Novin3dp/PJ3D608V3-MIPI-Bridge/Toshiba TC358870XBG mipi bridge.png

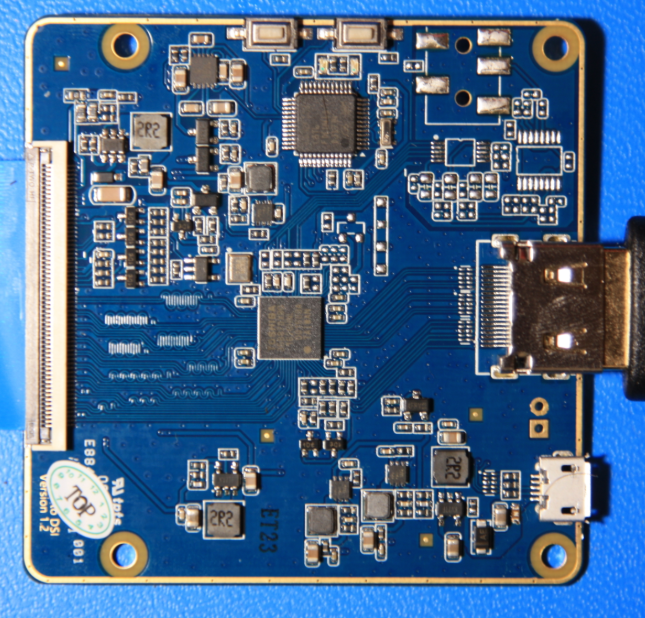
Toshiba TC358870XBG mipi bridge.png
