Novin3dp/PJ3D608V3-MIPI-Bridge/گزارش طراحی پنل DXQ608-X04 با درایور HX8252-A02 برای پرینتر رزینی.docx

# گزارش طراحی: پنل DXQ608-X04 با درایور HX8252-A برای پرینتر رزینی

Oct 8, 2026 · @Novin3dp

## ۱. خلاصه و یافته‌های کلیدی

این پنل یک LCD تک‌رنگ (بدون فیلتر رنگ) ۶٫۰۸ اینچ با ۱۶۲۰×۲۵۶۰ نقطه و گام ۵۱ میکرون است. درایور آن طبق بررسی خود شما HX8252-A است (نه A02) و دیتاشیت HX8252-A نسخه ۰۶ مبنای اعداد این گزارش است. روی کانکتور فقط یک پورت MIPI-DSI چهارلاین دیده می‌شود؛ پس طراحی درست یک مسیر ویدئویی واحد است: Spartan-6 ← یک SSD2828 ← پنل.

- تطبیق رزولوشن: ۱۶۲۰ ستون = ۵۴۰ پیکسل RGB × ۳. در HX8252-A مقدار RES=101b یعنی حالت 1080RGB×1920 که برای هر تراشه کانال‌های ۱–۸۱۰ و ۱۵۹۱–۲۴۰۰ یعنی دقیقاً ۱۶۲۰ کانال را فعال می‌کند (ص۲۸) و در جدول زمان‌بندی THA=540 پیکسل در هر پورت دارد (ص۷۶). سه ستون مجاور تک‌رنگ باید در یک پیکسل RGB بسته‌بندی شوند.
- تعداد خط: ۲۵۶۰ = ۳۲۰×۸. رجیستر VRES (۹ بیتی، گام ۸ خط، دامنه ۸۰ تا ۳۲۰) این مقدار را می‌دهد و ردیف‌های زمان‌بندی ۲۵۶۰ خطی در دیتاشیت A هست (ص۷۶)؛ ولی حالت 1080RGB رسماً ۱۹۲۰ خط دارد و توضیح VRES سقف را به V-display ربط می‌دهد (بخش ۱۰).
- یک یا دو تراشه: HX8252-A برای راه‌اندازی دو‌تراشه‌ای (Master/Slave با MIPI چپ/راست ۴+۴ لین) طراحی شده (ص۳۴)، ولی این پنل فقط یک پورت ۴ لین روی FPC دارد. تعداد IC روی شیشه را بشمارید؛ اگر یکی است مسیر این گزارش درست است.
- دو SSD2828: با یک پورت MIPI روی FPC فقط یکی لازم است. دومی فقط وقتی معنا دارد که پنل دو‌تراشه‌ای باشد.
- تغذیه: کانکتور فقط 1.8V، AVDD=+5.75V، AVEE=−5.75V و پایه‌های بک‌لایت دارد؛ پس PWRMD=11b (VSP/VSN خارجی، VGH/VGL داخلی). VCI پایه‌ی جدا ندارد و باید با اهم‌متر معلوم شود به AVDD وصل است.
- پیکسل‌کلاک: با ۲۵۶۰ خط و ۶۰ هرتز ۱۰۸٫۹ مگاهرتز (THT=700، TVT=2592) یعنی ۲٫۶ گیگابیت بر ثانیه؛ روی ۴ لین حدود ۶۵۳ مگابیت بر ثانیه برای هر لین (زیر سقف ۱ Gbps). SSD2828 این را می‌پذیرد، به شرط انتخاب درست مرجع PLL (بخش ۸ـب).
- اولین گام راه‌اندازی: حالت BIST داخلی HX8252 (رجیستر 0xB2 بیت ۰) بدون هیچ ویدئویی تغذیه، reset، GOA و نگاشت کانال‌ها را تست می‌کند.

## ۲. صفحات مطالعه‌شده و دلیل انتخاب

دیتاشیت DXQ608-X04 هفده صفحه است و فقط صفحات ۵ تا ۱۱ محتوای فنی دارند (بقیه فهرست، بازرسی ظاهری و بسته‌بندی‌اند). از دیتاشیت HX8252-A نسخه ۰۶ و دیتاشیت SSD2828QN4 نسخه ۱٫۳ این بخش‌ها را بررسی کردم؛ شماره‌ی صفحه‌ی HX8252-A همان «-P.» ابتدای هر صفحه و شماره‌ی SSD2828 شماره‌ی چاپی است.

دیتاشیت | صفحات | موضوع | چرا لازم است
DXQ608 | ۵–۷ | مشخصات مکانیکی، نقشه و جدول پین کانکتور | ابعاد، ناحیه فعال، اتصال‌ها
DXQ608 | ۸–۹ | حدود مطلق، ولتاژ تغذیه، اپتیک | ولتاژها و دما
DXQ608 | ۱۱ | زمان‌بندی MIPI و reset | حداقل‌های reset
HX8252-A | ۸–۱۴ | معرفی، پین‌ها (PWRMD، LNSW، LANSEL، CASCADE_ENB، BIST_EN) | پیکربندی سخت‌افزاری
HX8252-A | ۱۶–۲۷ | معماری تغذیه و توالی روشن/خاموش | توالی و حالت PWRMD=11
HX8252-A | ۲۸–۲۹ | رزولوشن، کانال‌های فعال، cascade | تطبیق ۱۶۲۰ ستون
HX8252-A | ۳۴–۴۵ | پروتکل DSI و نوع بسته‌ها | بسته‌های 0x23/0x29، 3Eh
HX8252-A | ۵۰–۵۳، ۶۵ | دستورات DCS | 0x10، 0x11، 0x29
HX8252-A | ۷۵–۷۷ | زمان‌بندی ورودی ویدئو | محاسبه pclk
HX8252-A | ۷۸–۸۱، ۹۶، ۱۰۵–۱۰۸ | نحوه‌ی نوشتن رجیستر، جدول و شرح صفحه ۰ | بایت‌های راه‌اندازی
HX8252-A | ۱۲۳ | BIST | تست اولیه
HX8252-A | ۱۴۱ | تشخیص نبود سیگنال و GAS | رفتار هنگام قطع
HX8252-A | ۱۴۶–۱۵۳ | مشخصات DC/AC، reset | سطوح و زمان‌ها
SSD2828 | ۱۲–۲۳ | بلوک‌دیاگرام و پین‌ها | رابط RGB و SPI
SSD2828 | ۲۵–۷۷ | رجیسترها (VICR، CFGR، PLL، LCFR) | تنظیم پل
SSD2828 | ۱۲۲–۱۲۳، ۱۳۷ | حالت‌های ویدئو و PLL | انتخاب مرجع PLL
SSD2828 | ۱۵۳–۱۶۰ | زمان‌بندی AC، reset، توالی روشن شدن | سقف pclk

بخش‌های pad و bump دیتاشیت HX8252-A (از ص۱۵۴ به بعد)، گاما و CABC برای این طراحی کاربردی ندارند. دیتاشیت HX8252-A02 که ابتدا ارسال شده بود فقط برای مقایسه خوانده شد و مبنای اعداد این گزارش نیست. محدودیت: متن PDF نمودارهای زمانی توالی تغذیه را درهم ریخته استخراج کرده، پس اعداد آن‌ها فقط از متن‌های قابل اعتماد گرفته شده و جاهای نامطمئن علامت خورده‌اند.

## ۳. مشخصات پنل و کانکتور ۵۰ پین

پنل ۱۶۲۰×۲۵۶۰ با ناحیه فعال 82.62×130.56 میلی‌متر، گام دقیقاً ۵۱ میکرون در هر دو جهت دارد (82.62/1620 و 130.56/2560)؛ قطر قطری ≈154٫5 میلی‌متر = ۶٫۰۸ اینچ.

پارامتر | مقدار | منبع
ابعاد خارجی | 87.02 × 138.56 × 1.3 mm | DXQ608 ص۵
درایور | HX8252-A (نام روی ص۵؛ نقشه‌ی ص۶ نام A02 هم دارد) | ص۵ و ۶
حالت نمایش | Normally Black، IPS | ص۵
ولتاژ منطقی | 1.8V (تیپ)، حد 1.7 تا 3.6V | ص۵ و ۸
تغذیه آنالوگ روی کانکتور | AVDD=+5.75V، AVEE=−5.75V | ص۷
دمای کار / نگهداری | −20..+70°C / −30..+70°C | ص۸
کنتراست / پاسخ | 1000 / 35ms (TR+TF) | ص۹
عبور نور با پلاریزر | 7٪ | ص۹
جریان مصرفی، ولتاژ LED، روشنایی | خالی در دیتاشیت | ص۸
Reset | حداقل پهنای پالس 10µs در دیتاشیت پنل و 20µs در HX8252؛ زمان کامل شدن 5ms (120ms اگر Sleep In) | ص۱۱

جدول پین‌ها (ص۷). نکته: پین‌های دیفرانسیلی در جدول به‌صورت متناوب آمده‌اند؛ جفت‌ها همان نام‌های یکسان‌اند (مثلاً D3 = پین ۸ و ۱۰).

پین | نام | شرح و نکته طراحی
1، 2، 6، 7، 12، 13، 18، 19، 24، 25، 30، 31، 36، 37، 42، 43 | GND | زمین؛ همه وصل شوند
3 | AVEE | −5.75V؛ ورودی VSN درایور
4 | AVDD | +5.75V؛ ورودی VSP درایور
5 | HS | «همگام‌ساز افقی»؛ در حالت MIPI بلااستفاده به‌نظر می‌رسد، خالی بگذارید تا تأیید شود
8، 10 | D3N، D3P | لین داده ۳
9، 11 | D0N، D0P | لین داده ۰
15، 17 | D1N، D1P | لین داده ۱
20، 22 | D2N، D2P | لین داده ۲
14، 16 | CLKN، CLKP | کلاک
21، 23، 26–29، 32–35، 50 | NC | باز
38 | RESET | ریست سخت‌افزاری، فعال‌پایین
39، 41 | VDD (1.8V) | تغذیه منطق (VDDI)
40 | TE | خروجی Tearing Effect (فقط با پیکربندی GPO)
44 | LEDPWM | PWM بک‌لایت سفید (برای پرینتر معمولاً بلااستفاده)
45، 46 | ID1/ID2 | شناسه ماژول؛ در FPC به VDDI وصل است
47، 49 | LEDK1 | کاتد بک‌لایت
48 | LEDA | آند بک‌لایت

## ۴. تطبیق ۱۶۲۰×۲۵۶۰ با HX8252

HX8252-A دو تراشه‌ی ۲۴۰۲ کاناله را cascade می‌کند؛ هر تراشه ۲۴۰۰ خروجی سورس دارد. در جدول‌های ۶٫۱ و ۶٫۲ (ص۲۸) حالت RES=101b (1080RGB×1920) برای هر تراشه کانال‌های ۱–۸۱۰ و ۱۵۹۱–۲۴۰۰ را فعال و ۸۱۱–۱۵۹۰ را غیرفعال می‌کند: ۸۱۰+۸۱۰ = ۱۶۲۰ کانال، دقیقاً برابر ستون‌های پنل. در جدول زمان‌بندی (ص۷۶) همین حالت THA=540 دارد، یعنی ۵۴۰ پیکسل RGB در هر پورت. نتیجه: پنل برای درایور یک تراشه با ۵۴۰ پیکسل RGB است که هر زیرپیکسل آن یک نقطه‌ی تک‌رنگ شده. فرض من این است که فقط یک تراشه روی شیشه است و پایه‌ی CASCADE_ENB بالا (حالت Single) است؛ اگر پنل دو تراشه داشته باشد، این بخش و بخش ۶ باید دوباره بررسی شوند.

پیامدهای طراحی:

- رجیستر 0xB3 (صفحه ۰): RES[2:0]=101b یعنی B3=05h. ZTYPE_SEL و PWRMD_XOR صفر بمانند. توجه: پیش‌فرض B3 در جدول رجیستر 03h (RES=011، 1280RGB×2048) است، ولی جدول ۶٫۱ پیش‌فرض را 000 می‌گوید؛ پس مقدار را صریحاً بنویسید (ص۲۸ و ۹۶).
- پنل از نوع Stripe فرض می‌شود (ZIGZAG_SEL=0، پیش‌فرض 0xB2=02h)، پس SR1 و SL1 غیرفعال‌اند. اگر تصویر ناهمگون شد این فرض را عوض کنید.
- NBW_SEL=1 (Normal Black) پیش‌فرض است و با متن دیتاشیت پنل (ص۵) می‌خواند.
- خطوط: ۲۵۶۰ = ۳۲۰×۸. VRES[8:0]=0x140: بایت 0xB4=0x40 و بیت VRES[8] یعنی بیت ۷ رجیستر 0xB6 باید ۱ شود. VRES_FIX=0 (پیش‌فرض) یعنی خطوط از VRES می‌آیند نه از RES. دامنه‌ی VRES در دیتاشیت A برابر ۸۰ تا ۳۲۰ و گام ۸ خط است (ص۱۰۶)، و مقدار پیش‌فرض 0x0F0 (۱۹۲۰ خط).
- ترتیب بسته‌بندی: هر پیکسل MIPI = [R,G,B] = ستون‌های 3k، 3k+1، 3k+2 تصویر تک‌رنگ. اگر چپ و راست برعکس بود LR_XOR (0xB2 بیت ۴) یا جابه‌جایی R/B (RB_SWAP، 0xB6 بیت ۴) را به‌جای تغییر FPGA امتحان کنید.

## ۵. تغذیه و توالی روشن/خاموش شدن

روی کانکتور هیچ پین VCI، VGH، VGL یا VCOM نیست، پس این‌ها داخل ماژول ساخته می‌شوند. چون AVDD/AVEE مستقیم از بیرون می‌آیند، حالت درست PWRMD[1:0]=11b است (پین پیش‌فرض بالا؛ ص۱۱، شکل ۵٫۵ ص۲۱): VSP/VSN خارجی، VGH/VGL با شارژ پمپ داخلی. VGH/VGL پیش‌فرض +15V/−10V هستند (0xBE=23h، 0xBF=14h) و با ±5.75V قابل‌دستیابی‌اند (محدوده‌ی خروجی VGH ‏8 تا 19V و VGL ‏−16 تا −6V؛ ص۱۴۷).

ریل | محدوده مجاز دیتاشیت | مقدار طراحی | نکته
VDDI | 1.7 تا 3.6V (حد مطلق 3.96V) | 1.8V | همان منطق FPC (پین ۳۹، ۴۱)
AVDD (VSP) | 4.0 تا 6.5V (حد مطلق 6.9V) | +5.75V | زیر 3.5V مکانیزم GAS فعال می‌شود
AVEE (VSN) | −4.0 تا −6.5V (حد مطلق −6.9V) | −5.75V | زیر −3.5V GAS
VCI | 2.7 تا 6.5V | احتمالاً داخل ماژول به AVDD وصل است | باید با اهم‌متر تأیید شود

نیازهای عملی:

- ریپل AVDD/AVEE را کم نگه دارید؛ این ریل‌ها مستقیماً منبع رانش سورس‌اند و خطای خروجی سورس خود IC بین ۲۰ تا ۵۰ میلی‌ولت (بسته به سطح خاکستری) است (ص۱۴۷).
- جریان AVDD/AVEE در هیچ‌یک از دیتاشیت‌ها نیامده (جریان مصرفی ص۸ خالی است)، فقط جریان تست ۶۴۰×۱۹۲۰ در HX8252 آمده: Ivdd≤18.3mA، Ivci≤2.5mA. برای تغذیه ±5.75V حداقل ۲۰۰ میلی‌آمپر هر ریل (با اندازه‌گیری نهایی) فرض کنید.
- پین VDD_OTP روی FPC نیست؛ هرگز برنامه‌ریزی OTP نکنید.

توالی پیشنهادی (از شکل‌های ص۲۶–۲۷؛ فاصله‌های دقیق شکل‌ها در متن استخراج‌شده ناخوانا بود و باید با خود PDF مقایسه شود):

1. VDDI (1.8V) را وصل کنید، RESET پایین نگه داشته شود، لین‌های MIPI در LP-11.
2. AVDD/AVEE را بالا بیاورید، چند میلی‌ثانیه صبر کنید.
3. RESET را رها کنید؛ حداقل پهنای پایین ۲۰ میکروثانیه (HX8252) — عملاً ۱ میلی‌ثانیه پایین؛ بعد از آن HX8252-A بیش از ۱ ms برای بارگذاری OTP می‌خواهد (شکل ۵٫۶ ص۲۶) و دیتاشیت پنل ۵ ms (ص۱۱ پنل: 5ms؛ 120ms اگر از Sleep In آمده).
4. کدهای راه‌اندازی رجیستر را بفرستید (جدول بخش ۸)، سپس HS کلاک و ویدئوی پایدار.
5. DCS 0x11 (Sleep Out)، حداقل ۱۲۰ میلی‌ثانیه صبر، سپس DCS 0x29 (Display On).
6. خاموش‌کردن: DCS 0x28، DCS 0x10، حداقل ۱۰۰ میلی‌ثانیه (ص۲۷)، سپس قطع ویدئو و سپس تغذیه‌ها. در قطع ناگهانی، مدار GAS تصویر را تخلیه می‌کند.

## ۶. MIPI: زمان‌بندی ویدئو، پیکسل‌کلاک و نرخ لین

زمان‌بندی ویدئو بر اساس جدول صفحه ۷۶ دیتاشیت HX8252-A (حالت 1080RGB×1920 با VRES=2560 خط؛ مقادیر typical):

پارامتر | افقی (pclk) | پارامتر | عمودی (خط)
THT (کل) | 700 | TVT (کل) | 2592
THS (HSYNC) | 20 | TVS (VSYNC) | 2
THB (back porch) | 70 | TVB | 12
THA (فعال) | 540 | TVA | 2560
THF (front porch) | 70 | TVF | 18

جمع افقی 20+70+540+70 = 700 و جمع عمودی 2+12+2560+18 = 2592 است. در MIPI هر پورت نصف پیکسل‌ها را می‌برد، بنابراین THA=540 یعنی ۵۴۰ پیکسل RGB (۱۶۲۰ ستون تک‌رنگ) در هر پورت.

نرخ فریم و سرعت لاین (محاسبه: pclk = THT×TVT×fps؛ سرعت هر لاین = pclk×24/4 با ۴ لاین):

نرخ فریم | pclk | سرعت هر لاین MIPI
60 Hz | 108.86 MHz | 653 Mbps
50 Hz | 90.72 MHz | 544 Mbps
40 Hz | 72.58 MHz | 435 Mbps
30 Hz | 54.43 MHz | 327 Mbps

یادداشت‌ها:

- زمان یک خط 700/108.86 MHz ≈ 6.43 µs است؛ زمان افت سورس ۴٫۲ µs (ص۱۵۲) و باید داخل این بازه جا شود.
- سقف سرعت MIPI در این دیتاشیت 1 Gbps/lane است (ص۱۱)؛ ۶۵۳ Mbps با حاشیه کافی جا می‌شود. برای چاپگر رزینی ۳۰ Hz هم کافی است و فشار روی FPGA و SSD2828 را نصف می‌کند.
- دستور 3Eh (write memory continue) در ص۳۸ و حداکثر ۴۸ فرمان در هر burst پرسرعت در ص۳۷ آمده است.
- بین فرمان‌های HS باید حداقل ۱۰ µs در LP بماند (ص۷۸).
- رفتار هنگام قطع سیگنال ویدئو (no-signal) در ص۱۴۱ شرح داده شده؛ برای اطمینان قبل از قطع pclk پنل را به Sleep ببرید.

## ۷. نمودار معماری سیستم

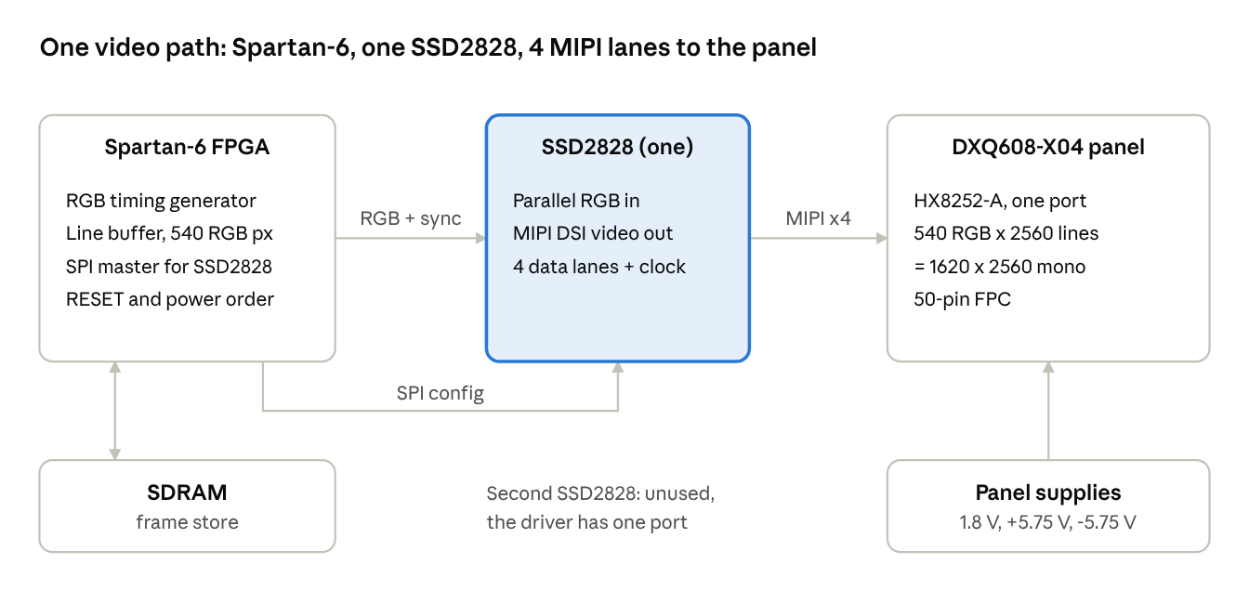
[picture p3: figure]
معماری مسیر ویدئو · FPGA → SSD2828 → پنل

معماری مسیر ویدئو · FPGA → SSD2828 → پنل

مسیر تصویر یکی است: FPGA پیکسل‌های RGB و سینک را به یک SSD2828 می‌دهد و آن همان را به MIPI DSI چهارلین تبدیل می‌کند؛ همان FPGA از طریق SPI رجیسترهای SSD2828 را پر می‌کند و در زمان راه‌اندازی دستورهای DCS را به همان طریق (انفجار LP/HS) به HX8252 می‌فرستد. SDRAM فقط با FPGA ارتباط دارد. پین RESET (۳۸) و ترتیب روشن شدن تغذیه‌ها (بخش ۵) هم با FPGA کنترل می‌شود. شکل فقط مسیر پیشنهادی من را نشان می‌دهد؛ جزئیات SSD2828 در بخش ۸ـب آمده است.

## ۸. رجیسترها و دنباله‌ی راه‌اندازی

نحوه‌ی نوشتن: رجیسترهای HX8252-A با بسته‌ی Generic Long Write (DI=0x29) نوشته می‌شوند؛ بایت اول داده آدرس شروع و بایت‌های بعدی مقدارها هستند. انتخاب صفحه‌ی رجیستر با Generic Short Write دوپارامتری (DI=0x23) و داده‌ی B0 pp انجام می‌شود. مقدار پیش‌فرض B0 برابر 0Fh است، پس صفحه‌ی ۰ را صریحاً انتخاب کنید. دستورهای DCS مثل 0x11 و 0x29 بسته‌ی کوتاه بدون پارامتر (DI=0x05) هستند. بین فرمان‌های HS حداقل ۱۰ µs در LP بمانید (ص۷۸) و در هر burst بیش از ۴۸ فرمان نفرستید (ص۳۷).

رجیسترهای صفحه‌ی ۰ که برای این پنل مهم‌اند:

آدرس | بیت‌ها | پیش‌فرض | مقدار این پروژه | کار
0xB2 | [4] LR_XOR، [3] ZIGZAG_SEL، [1] NBW_SEL، [0] BIST | 02h | 02h (عادی)، 03h (BIST) | جهت چپ/راست، نوع پنل (Stripe=0)، Normal Black=1، تست داخلی
0xB3 | [5:4] PWRMD_XOR، [3] VRES_FIX، [2:0] RES | 03h (جدول رجیستر) | 05h | RES=101b یعنی 1080RGB×1920 (۸۱۰+۸۱۰ کانال)؛ VRES_FIX=0 یعنی خطوط از VRES
0xB4 | [7:0] VRES[7:0] | F0h | 40h | بخش پایین تعداد خط÷۸
0xB5 | ZDATA | A5h | A5h | فقط برای Zigzag؛ تغییرش ندهید
0xB6 | [7] VRES[8]، [4] RB_SWAP، [1] DITHER، [0] D_GAM | 00h | 80h | VRES[8]=1 پس VRES=0x140=320 یعنی ۲۵۶۰ خط
0xB7 | [0] CASCADE_XOR | — | 00h | حالت Single (پین CASCADE_ENB بالا)
0xB8 | [7] GOA_EN، [6] VCOM_EN، [5] PNSW، [3:2] LNSW، [1:0] LANSEL | C0h | C0h | GOA و VCOM روشن، چهار لین

توجه: بیت‌های BIST، PWRMD، PNSW، LNSW و LANSEL با پین متناظر XOR می‌شوند. پین BIST_EN پیش‌فرض پایین است، پس نوشتن ۱ در بیت BIST حالت تست را روشن می‌کند. برای PWRMD هم پین پیش‌فرض بالا و XOR=00 همان 11b (VSP/VSN خارجی، VGH/VGL داخلی) را می‌دهد. پیش‌فرض B3 در جدول رجیستر 03h و در جدول ۶٫۱ برابر RES=000 است؛ پس B3 را همیشه صریحاً بنویسید.

دنباله‌ی پیشنهادی (قبل از ارسال ویدئو):

گام | بسته | بایت‌ها | انتظار بعد
۱ | Hardware reset | RESET پایین ≥20 µs | >1 ms (بارگذاری OTP)، پیشنهاد ۵ ms
۲ | Short 0x23، انتخاب صفحه | B0 00 | ≥10 µs LP
۳ | Long 0x29، WC=5 | B3 05 40 A5 80 | ≥10 µs LP
۴ | (اختیاری) Short 0x23 برای BIST | B2 03 … سپس B2 02 برای بازگشت | چند ثانیه نگاه کردن
۵ | شروع HS کلاک و ویدئوی پایدار | از SSD2828 | چند فریم
۶ | DCS 0x11 (Sleep Out) | 11 | ≥120 ms
۷ | DCS 0x29 (Display On) | 29 | —

نکات مهم:

- بسته‌ی B3 05 40 A5 80 فرض می‌کند بایت‌ها پشت‌سرهم در B3، B4، B5 و B6 می‌نشینند. با خواندن بازگشتی یا شمردن خطوط تصویر تأیید کنید.
- ماژول احتمالاً مقدارهای بهینه را از OTP می‌خواند (ص۱۱ پنل). بایت‌های B1 (VENDER_ID) را دست نزنید.
- نوشتن 0xB6=80h بقیه‌ی بیت‌های B6 (RB_SWAP، دیترینگ، گامای دیجیتال) را صفر می‌کند؛ اگر OTP غیرصفر بوده، اول مقدار فعلی را بخوانید.
- اگر پنل دو تراشه‌ی HX8252-A دارد (Master/Slave)، تنظیم CASCADE و تقسیم چپ/راست متفاوت است و این جدول باید بازبینی شود.

## ۸ـب. SSD2828: محدودیت‌ها و تنظیم

این بخش از دیتاشیت SSD2828 (QN4 Rev 1.3) برداشته شده است.

موضوع | مقدار دیتاشیت | نتیجه برای این پروژه
ورودی | RGB تا ۲۴ بیت + SPI برای رجیستر | FPGA مستقیماً pclk، HS، VS، DE و ۲۴ بیت داده می‌دهد
خروجی | یک پورت DSI، تا ۱ Gbps در هر لین | یک چیپ برای پنل با یک پورت کافی است
محدودیت pclk | tpclk ≥ 24T، با T = 1/(نرخ PLL × تعداد لین) | pclk ≤ نرخ لین × ۴ ÷ ۲۴؛ برای 108.86 MHz نرخ لین حداقل 653 Mbps است
PLL | 62.5 تا 1000 MHz | پیشنهاد حدود 800 Mbps (UI=1.25 ns؛ داخل بازه‌ی 1.0–12.5 ns پنل)
مرجع PLL | fIN/fREF بین 5 تا 100 MHz | pclk=108.9 MHz از 100 MHz بالاتر است، پس CSS=1 (مرجع از pclk) ممکن نیست؛ از TX_CLK (8–30 MHz، مثلاً 25 MHz) استفاده کنید
ریست | RESET ≥10 ms | قبل از SPI حداقل ۱۰ ms صبر کنید
تغذیه | MVDD 1.2 V، VDDIO 1.8 یا 3.3 V | VDDIO را با سطح FPGA یکی کنید
SPI | دوره ≥ 8T | با 25 MHz مرجع، SPI را کند (چند MHz) نگه دارید

نکات اجرایی:

- زمان‌بندی ویدئو (بخش ۶) در رجیسترهای VICR به‌صورت VSA=2، VBP=12، VFP=18، HSA=20، HBP=70، HFP=70، پیکسل فعال=540 و خط فعال=2560 تنظیم می‌شود. جای دقیق بیت‌ها را از بخش رجیسترها در دیتاشیت SSD2828 بخوانید؛ من آن‌ها را اینجا حدس نمی‌زنم.
- فرمان‌های HX8252 (B0، B3 و غیره) از راه SPI به رجیسترهای packet-size و packet-data (0xBC و 0xBF) و با CFGR در حالت LP فرستاده می‌شوند؛ بعد از آن حالت Video و HS را روشن کنید. فرمت دقیق فریم SPI (دیتاشیت ص۱۳۹ به بعد) هنوز استخراج نشده و باید پیش از نوشتن کد SPI تأیید شود.
- ترتیب: ریست SSD2828 → PLL و تایمینگ → ارسال دستورهای HX8252 در LP → روشن کردن ویدئوی HS → Sleep Out و Display On.
- سرعت لین را روی نمونه با اسکوپ یا خطای تصویر بسنجید؛ اگر ناپایدار بود نرخ فریم را به ۵۰ یا ۴۰ هرتز ببرید (بخش ۶).

## ۸ـج. مسیر اختیاری: MIPI مستقیم از FPGA بدون SSD2828

مدل FPGA شما XC6SLX9-2TQG144C است. از دیتاشیت DS162 و دانش عمومی D-PHY نتیجه می‌گیریم که این مسیر شدنی است، ولی خطر بیشتری از مسیر با SSD2828 دارد. پیشنهاد: نمونه‌ی اول با SSD2828، مسیر مستقیم را جاگذاری اختیاری روی همان برد بگذارید.

موضوع | مقدار / نتیجه | منبع
سرعت فرستنده | OSERDES2 با پهنای ۴ تا ۸ بیت در grade ‏-2 تا 950 Mb/s → برای 653–800 Mbps کافی است | DS162 جدول ۲۵
سطح HS | LVDS_25: VOD ≈ 247–454 mV، VOCM ≈ 1.125–1.375 V؛ D-PHY نوسان و common-mode حدود 200 mV می‌خواهد → شبکه‌ی مقاومتی لازم است | DS162 جدول ۱۰ + دانش عمومی D-PHY
حالت LP | سطح ~1.2 V تک‌سر روی همان جفت‌ها → پین‌های GPIO جدا و مقاومت‌های ترکیبی | دانش عمومی D-PHY
بانک | LVDS_25 نیاز به VCCO=2.5V دارد؛ خروجی LVCMOS12 در همان بانک ممکن نیست | DS162 جدول ۸
تعداد پین | ۵ جفت HS + ۱۰ پین LP ≈ ۲۰ پین؛ تعداد دقیق I/O و پین‌های مناسب BUFPLL را از UG385 بگیرید | تخمین، نیاز به تأیید
کنترلر حافظه (MCB) | در بسته‌ی TQG144 وجود ندارد → کنترلر SDRAM باید در منطق FPGA نوشته شود. برای SDR ساده است؛ برای DDR نه | DS162 جدول ۲۵، یادداشت ۴
VCCINT | بازه‌ی استاندارد 1.14–1.26 V | DS162 جدول ۲

کارهای RTL در مسیر مستقیم:

- ماژول فرستنده‌ی D-PHY با ۴ لین داده و یک کلاک، هر کدام با OSERDES2 و ماشین حالت LP-11 → LP-01 → LP-00 → HS و بایت sync.
- ساخت بسته‌های DSI: هدر با ECC، داده با CRC-16، بسته‌های سینک و پیکسل و تقسیم بایت‌ها بین چهار لین.
- ارسال دستورهای راه‌اندازی HX8252-A (بخش ۸) مستقیماً از همین ماژول با رعایت ≥10 µs فاصله‌ی LP و ≤48 فرمان در هر burst.
- تست با اسکوپ پرسرعت لازم است؛ بدون آن عیب‌یابی شبکه‌ی مقاومتی و زمان‌بندی دشوار است.

## ۹. طراحی داخلی FPGA و SDRAM

اعداد پایه (محاسبه‌شده از مشخصات پنل و زمان‌بندی بخش ۶):

کمیت | مقدار
یک فریم ۱ بیت در پیکسل (1620×2560) | 4٬147٬200 بیت = 518٬400 بایت
یک خط ۱ بیتی | 1620 بیت = 540 پیکسل RGB × 3 بیت
یک فریم ۸ بیت در پیکسل (سطح خاکستری) | 4٬147٬200 بایت
پهنای باند خواندن در ۶۰ هرتز، ۱ بیت | حدود 31 MB/s
پهنای باند خواندن در ۶۰ هرتز، ۸ بیت | حدود 249 MB/s
زمان یک خط (THT=700 در 108.9 MHz) | حدود 6.43 µs

بلوک‌های پیشنهادی (برای هر کدام یک ماژول HDL جدا):

- کلاک و PLL: پیکسل‌کلاک مستقل از کلاک SDRAM بسازید و بین دو دامنه از FIFO ناهم‌زمان استفاده کنید. کلاک را تا پایدار شدن PLL بیرون ندهید.
- مولد زمان‌بندی: شمارنده‌ی افقی تا 700 و عمودی تا 2592 با HSYNC=20، back porch=70، فعال=540، front porch=70 و عمودی 2/12/2560/18. خروجی‌ها: HS، VS، DE (نام پین‌ها طبق دیتاشیت SSD2828؛ pclk≈108.9 MHz) و داده‌ی 24 بیتی با لبه‌ی کلاک مشخص. خروجی را با رجیستر خروجی IOB (مثلاً ODDR2 برای کلاک) بسازید تا ستاپ/هولد ثابت بماند.
- بازیاب فریم (SDRAM): در هر خط، ۱۶۲۰ بیت (یا ۱۶۲۰ بایت در حالت ۸ بیت) را در یک برست بخواند و در بافر خط بنویسد. دو بافر خط (پینگ‌پونگ) لازم است تا خواندن خط بعدی با خروجی خط جاری هم‌زمان شود. زمان ۶٫۴۳ µs برای یک برست کوچک کافی است؛ نگرانی اصلی refresh حافظه است.
- بسته‌بندی پیکسل: هر سه بیت مجاور (ستون‌های 3k، 3k+1، 3k+2) یک پیکسل RGB می‌سازند: بیت ۱ → کانال = 0xFF، بیت ۰ → 0x00. اگر بخواهید سطوح خاکستری (آنتی‌آلیاس) بدهید، همین بیت‌ها ۸ بیتی می‌شوند و نیاز به حافظه و پهنای باند ۸ برابر دارید. این تصمیم محدودیت طراحی شماست و در بخش ۱۱ پرسیده شده.
- SPI به SSD2828: یک master ساده با جدول ROM از دستورها (بخش ۸)؛ قبل از روشن شدن ویدئو اجرا می‌شود و بعدش به صورت Sleep Out / Display On دنبال می‌شود.
- ترتیب روشن شدن: یک ماشین حالت که مطابق بخش ۵ تغذیه‌ها، RESET و راه‌اندازی را جلو ببرد و به همین ترتیب خاموش کند.
- انتخاب لایه: با فریم‌بافر دوگانه در SDRAM؛ جابه‌جایی فقط در شروع vertical blanking انجام شود تا خط کاملی مخلوط نشود.

ترتیب مورد استفاده برای تست: ۱) BIST داخلی HX8252؛ ۲) الگوی تست ساخته‌شده در FPGA (نوارهای سیاه/سفید و شطرنجی) بدون SDRAM؛ ۳) تصویر از SDRAM. هر مرحله مشکلات را جدا می‌کند: BIST تأییدکننده‌ی پنل و تغذیه، الگوی داخلی تأییدکننده‌ی SSD2828 و زمان‌بندی، SDRAM تأییدکننده‌ی مسیر داده.

## ۱۰. ناسازگاری‌ها، ابهام‌ها و ریسک‌ها

موضوع | آنچه دیتاشیت‌ها می‌گویند | تصمیم یا کار لازم
درایور | ص۵ پنل «HX8252-A»؛ نقشه‌ی ص۶ نام A02 دارد. شما روی تراشه HX8252-A را دیدید | مبنای گزارش HX8252-A است
یک یا دو تراشه | HX8252-A برای cascade دو تراشه طراحی شده؛ پنل ۱۶۲۰ کانال لازم دارد که با حالت Single و RES=101b جور است | تعداد تراشه روی شیشه را با شکل نقشه یا سازنده تأیید کنید
VCI | ص۸ پنل VCI 2.7–6.5V دارد ولی کانکتور پین VCI ندارد؛ HX8252-A ورودی VCI دارد | احتمالاً داخل ماژول به AVDD وصل است؛ با اهم‌متر چک کنید
پهنای reset | پنل ≥10 µs؛ HX8252-A ≥20 µs و >1 ms برای OTP | ۱ ms پایین نگه دارید و ۵ ms صبر کنید
سقف خطوط و VRES | VRES دامنه‌ی 80–320 (گام ۸) دارد؛ توضیحش می‌گوید خط حداکثر کمتر از V-display باشد | برای ۲۵۶۰ مبهم است؛ با BIST و الگوی تست بررسی شود
پیش‌فرض B3 | جدول رجیستر 03h؛ جدول ۶٫۱ RES=000 | B3 را همیشه صریح بنویسید
THT | typical=700 با مجموع بخش‌ها (700) می‌خواند | اگر ناپایدار بود نرخ فریم را پایین بیاورید
شکل‌های توالی تغذیه | متن ص۲۶–۲۷ درهم‌ریخته است | با PDF اصلی مقایسه کنید
پین‌های HS و TE | ص۷ پنل فقط نام می‌دهد | بلااستفاده رها کنید تا با آزمایش مشخص شود
عبور UV | فقط «7٪» برای نور مرئی؛ UV (مثلاً 405 nm) ذکر نشده | از سازنده بپرسید یا اندازه بگیرید
مرجع PLL در SSD2828 | fIN/fREF حداکثر 100 MHz | با pclk=108.9 MHz از TX_CLK (مثلاً 25 MHz) استفاده کنید
قالب SPI SSD2828 | فریم SPI هنوز از دیتاشیت (ص۱۳۹–۱۴۷) استخراج نشده | قبل از نوشتن RTL تأیید شود
کنترلر حافظه در TQG144 | XC6SLX9 در TQG144 بدون MCB است (DS162 جدول ۲۵) | کنترلر SDR نرم نوشته شود؛ نوع حافظه (SDR یا DDR) تأیید شود

رجیستر 0xB2: بیت ۰ BIST، بیت ۱ Normal Black، بیت ۳ نوع پنل (Stripe=0) و بیت ۴ جهت اسکن است.

## ۱۱. مراحل بعدی و ورودی‌های لازم

ترتیب پیشنهادی کار روی مدار و کد:

1. قبل از هر چیز، روی نمونه‌ی پنل با اهم‌متر ببینید پین ۳ و ۴ کانکتور به کدام ریل داخلی می‌روند و آیا VCI به AVDD وصل است.
2. تغذیه‌های 1.8V، +5.75V و −5.75V را با ترتیب بخش ۵ و محدودیت جریان بسازید؛ جریان را با اولین روشن شدن اندازه بگیرید.
3. حالت BIST (0xB2=03h) را بدون ویدئو امتحان کنید تا سلامت پنل، تغذیه و نگاشت کانال‌ها مشخص شود.
4. SPI به SSD2828 را راه بیندازید (ابتدا فقط خواندن ID رجیستر) و بعد بسته‌های بخش ۸ را ارسال کنید.
5. الگوی سیاه/سفید/نواری از داخل FPGA بدون SDRAM نمایش دهید و ترتیب ستون‌ها (RGB → سه ستون) و جهت را چک کنید.
6. سپس بازیاب از SDRAM و جابه‌جایی لایه را اضافه کنید.

ورودی‌هایی که برای نهایی کردن گزارش لازم است:

- تعداد تراشه‌های HX8252-A روی شیشه (یک یا دو) و در صورت امکان نقشه‌ی ماژول.
- مدل دقیق Spartan-6، پکیج و SDRAM (ظرفیت و عرض باس) برای محاسبه‌ی باند و منابع.
- نحوه‌ی رسیدن لایه‌ها به FPGA (کارت حافظه، USB، میکروکنترلر دیگر).
- اینکه آنتی‌آلیاس خاکستری لازم است یا تصویر صرفاً سیاه و سفید است.
- نوع منبع نور (UV) و اینکه بک‌لایت اصلی پنل حذف می‌شود یا نه.
