Novin3dp/PJ3D608V3-MIPI-Bridge/LS055R1SX04_LCY-pin convert-2.jpg

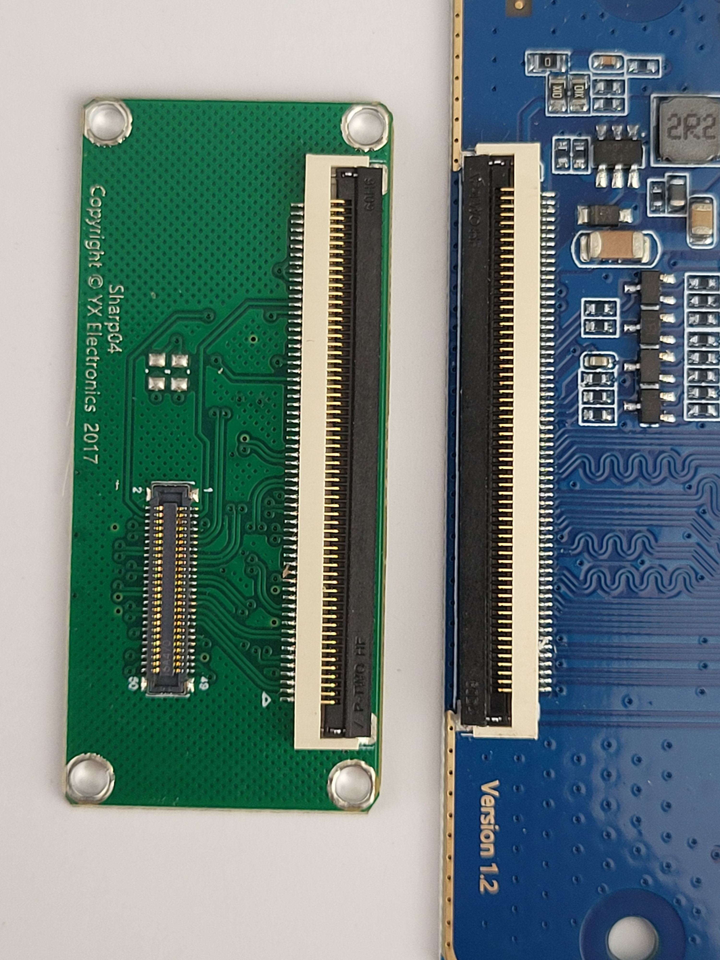
LS055R1SX04_LCY-pin convert-2.jpg
