Novin3dp/PJ3D608V3-MIPI-Bridge/BOM_MIPI-HDMI bridge.xlsx

ID | Name | Designator | Footprint | Quantity
1 | CS4344-CZZ | U1 | TSSOP-10_L3.0-W3.0-P0.50-LS4.9-BL | 1
2 | mh2322 | U10 | SOT23-5 | 1
3 | MMST4401-7-F | Q5,Q4,Q3,Q2,Q1 | SOT-323-3_L2.0-W1.3-P1.30-LS2.1-BR | 5
4 | 0.1u | C6,C5,C3,C2,C1 | C0402 | 5
5 | 0.1u | C4 | C0603 | 1
6 | lps f57u1 | U4 | SOT-323-6L | 1
7 | 1m | L2 | IND-SMD_L3.8-W3.8_SLF0302 | 1
8 | 1m | L1 | L0402 | 1
9 | 1k | R18,R17,R16,R15,R14,R13,R12,R11,R10,R9,R8,R7,R5,R6,R3,R4,R2,R1 | R0402 | 18
10 | CF31601D0R0-05-NH | FPC1 | FPC-SMD_CF31601D0R0-05-NH | 1
11 | none | U11 | LT-DD-10_V | 1
12 | MMST4401-7-F | Q8 | SOT-323-3_L2.0-W1.3-P1.30-LS2.1-BR | 1
13 | 0.1u | C18,C17,C16,C15,C14,C13,C12 | C0402 | 7
14 | 1k | R33,R32,R31 | R0402 | 3
15 | MMST4401-7-F | Q7,Q6 | SOT-323-3_L2.0-W1.3-P1.30-LS2.1-BR | 2
16 | 0.1u | C11,C10,C7 | C0402 | 3
17 | 0.1u | C9 | C0603 | 1
18 | 0.1u | C8 | C0805 | 1
19 | lps f57u1 | U3 | SOT23-6_L3.1-W3.1-P0.95-BL | 1
20 | 1m | L4,L3 | L0402 | 2
21 | 1k | R24,R30,R29,R28,R27,R26,R25,R23,R21,R22,R20,R19 | R0402 | 12
22 | 1N4007W | D1 | SOD-106_L2.0-W1.3-RD | 1
23 | none | U8,U7 | SOT23-5 | 2
24 | MMST4401-7-F | Q9 | SOT-323-3_L2.0-W1.3-P1.30-LS2.1-BR | 1
25 | 0.1u | C36,C35,C33,C32,C30,C28,C26,C25,C23,C22,C20,C19 | C0402 | 12
26 | 0.1u | C34,C31,C29,C27,C24,C21 | C0805 | 6
27 | 0.1u | C66 | C0603 | 1
28 | lps f57u1 | U6,U5 | SOT-323-6L | 2
29 | USB-CON-MICRO-B-5S | USB1 | MICRO-USB-SMD_MICRO-5P5.9 | 1
30 | 1m | L10,L9,L8,L5 | IND-SMD_L3.8-W3.8_SLF0302 | 4
31 | 1m | L7,L6 | L0402 | 2
32 | 1k | R47,R46,R45,R44,R43,R42,R41,R40,R39,R38,R37,R36,R35,R34,R76,R75,R74 | R0402 | 17
33 | CF04V3T4R0 | F1 | F0402 | 1
34 | 0.1u | C37 | C0402 | 1
35 | 128AA19CBCN | CN1 | HDMI-SMD_128AA19CBCN | 1
36 | 1k | R48,R49,R50,R51,R52,R53,R54,R55,R56,R57,R58,R59,R60 | R0402 | 13
37 | BC857W 3F SOT-323 | Q10,Q11 | SOT-323-3_L2.2-W1.3-P1.30-LS2.1-BL | 2
38 | FC-F1005UGK-520M5 | LED2,LED1 | LED0402-RD | 2
39 | 32.768KHz | X1 | FC-135R_L3.2-W1.5 | 1
40 | 0.1u | C47,C49,C51,C62,C63,C64,C65 | C0402 | 7
41 | 1m | L11 | L0402 | 1
42 | HDR-F-2.54_2x2 | H1 | TEST PADS | 1
43 | 1k | R68,R69,R70,R71,R72,R73 | R0402 | 6
44 | KSR251GLFS | SW1,SW2 | KEY-SMD_2P-L6.0-W3.8-P7.30-L | 2
45 | GD32F103C8T6 | U2 | TQFP-48_L7.0-W7.0-P0.50-LS9.0-BL | 1
46 | 0.1u | C38,C39,C40,C41,C42,C43,C44,C50,C55,C56,C57,C58,C59,C60,C61 | C0402 | 15
47 | TC358870XBG | U12 | P-VFBGA-80_L7.0-W7.0-R10-C10-P0.65-TL | 1
48 | 1k | R61,R62,R63,R64 | R0402 | 4
49 | 40MHz | X2 | OSC-SMD_4P-L2.0-W1.6-BL | 1
50 | 2sc2712y | Q12 | SOT-323-3_L2.0-W1.3-P1.30-LS2.1-BR | 1
51 | 0.1u | C54,C53,C45 | C0402 | 3
52 | 5p | C52 | C0402 | 1
53 | 1000p | C48,C46 | C0402 | 2
54 | 1k | R67,R66 | R0402 | 2
55 | 1.5k | R65 | R0402 | 1
