Novin3dp/PJ3D608V3-MIPI-Bridge/(list of files, drawings)

Other design files:
PCB_2020-11-19_18-02-21_2026-10-13.pcbdoc
